Goatfox32/3D-Graphics-System/(commit log)

2026-04-04 Initial command chain
2026-04-09 Fixed rasterizer clock, added dual clock to frame buffer
    [graphics_system_top.sv]
2026-04-09 Added frame buffer busy checking
2026-04-10 Wired newest changes
2026-04-10 Fixed small wiring bug
    [graphics_system_top.sv]
2026-04-12 Bring frame_buffer.sv from DoubleBufferWork branch into main
2026-04-12 Wiring fix
2026-04-30 Remove Command Flow Diagram from README
    Removed the Command Flow Diagram section and its image reference from the README.
